OjasMishra32/volition/design/out/torque_speed_hip.png

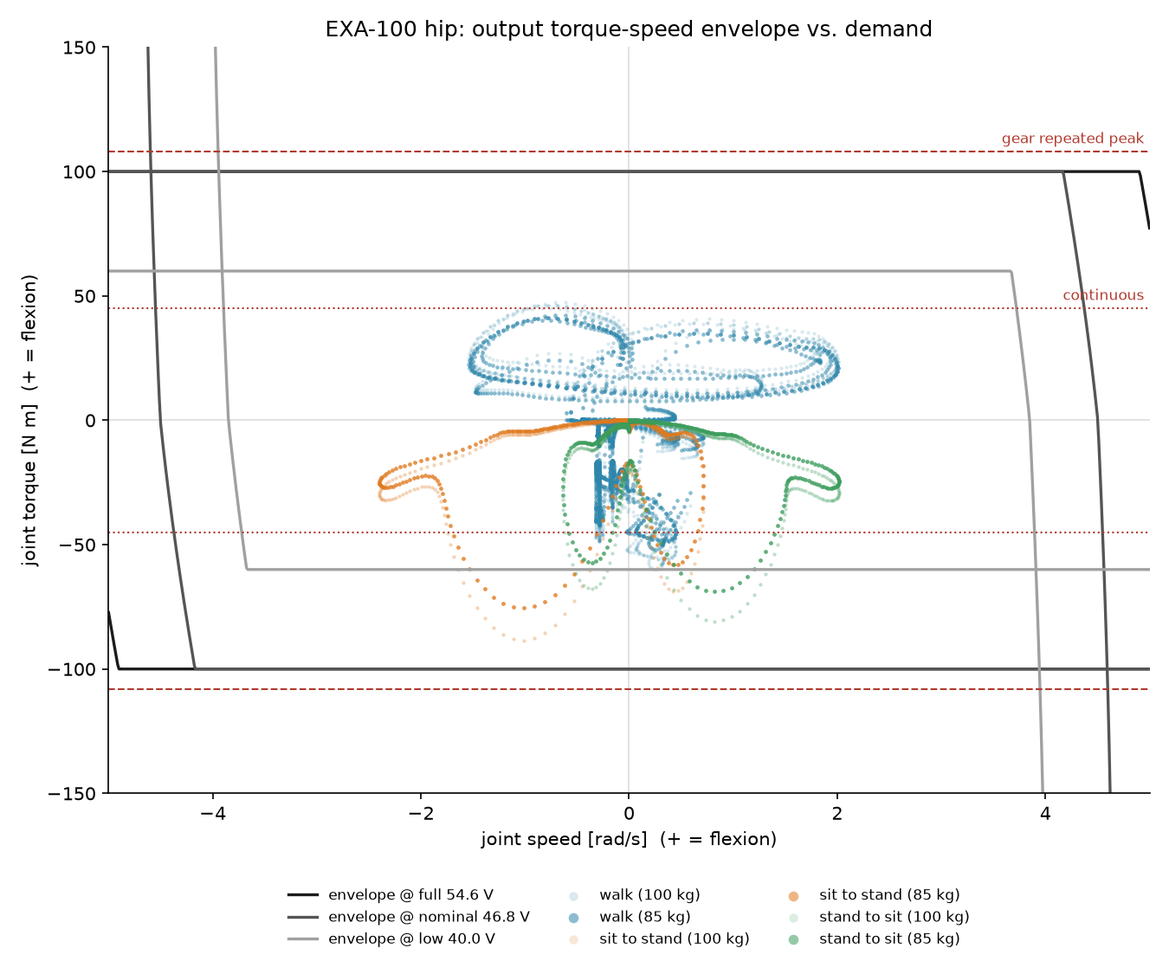
design/out/torque_speed_hip.png
