OjasMishra32/volition/design/out/torque_speed_knee.png

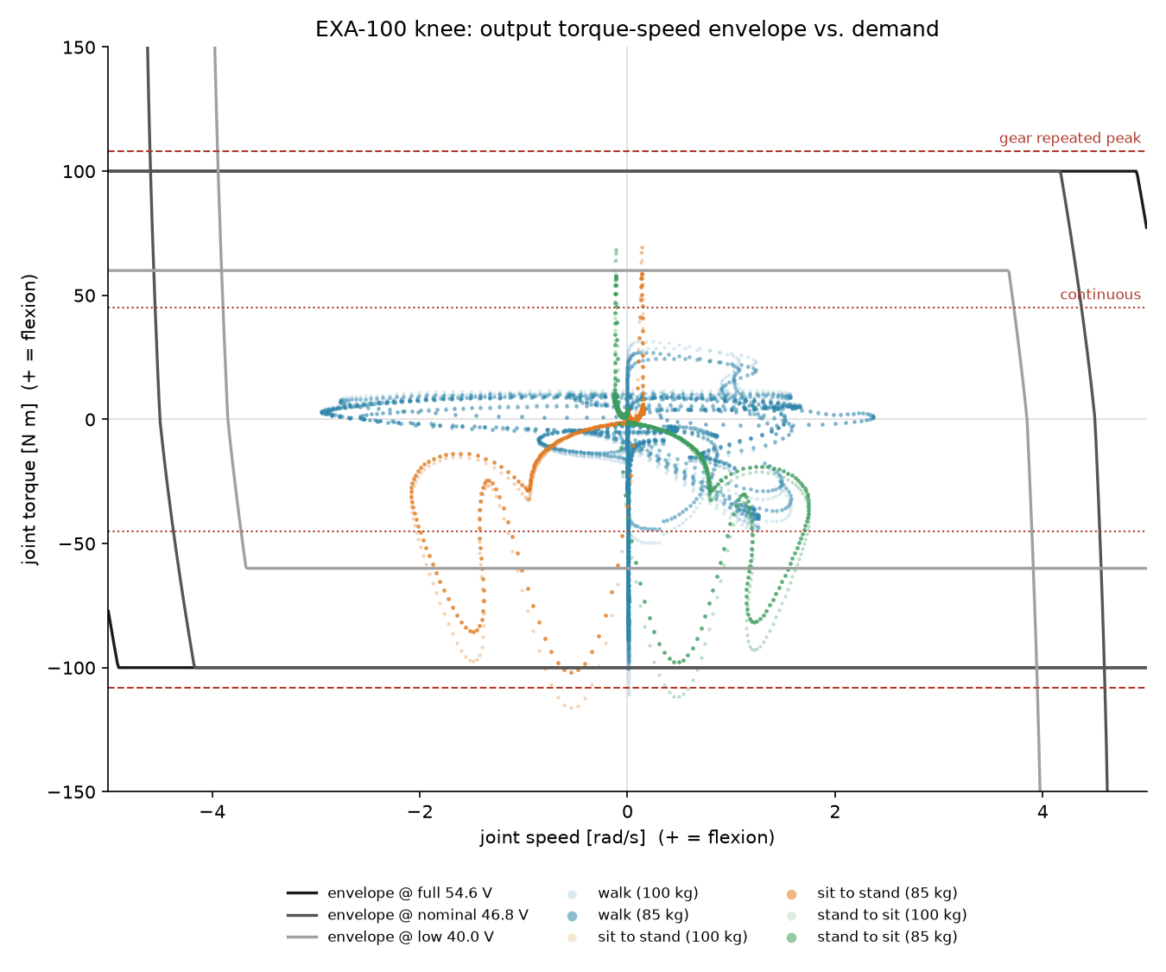
design/out/torque_speed_knee.png
