OjasMishra32/volition/sim/out/kinematics_check.png

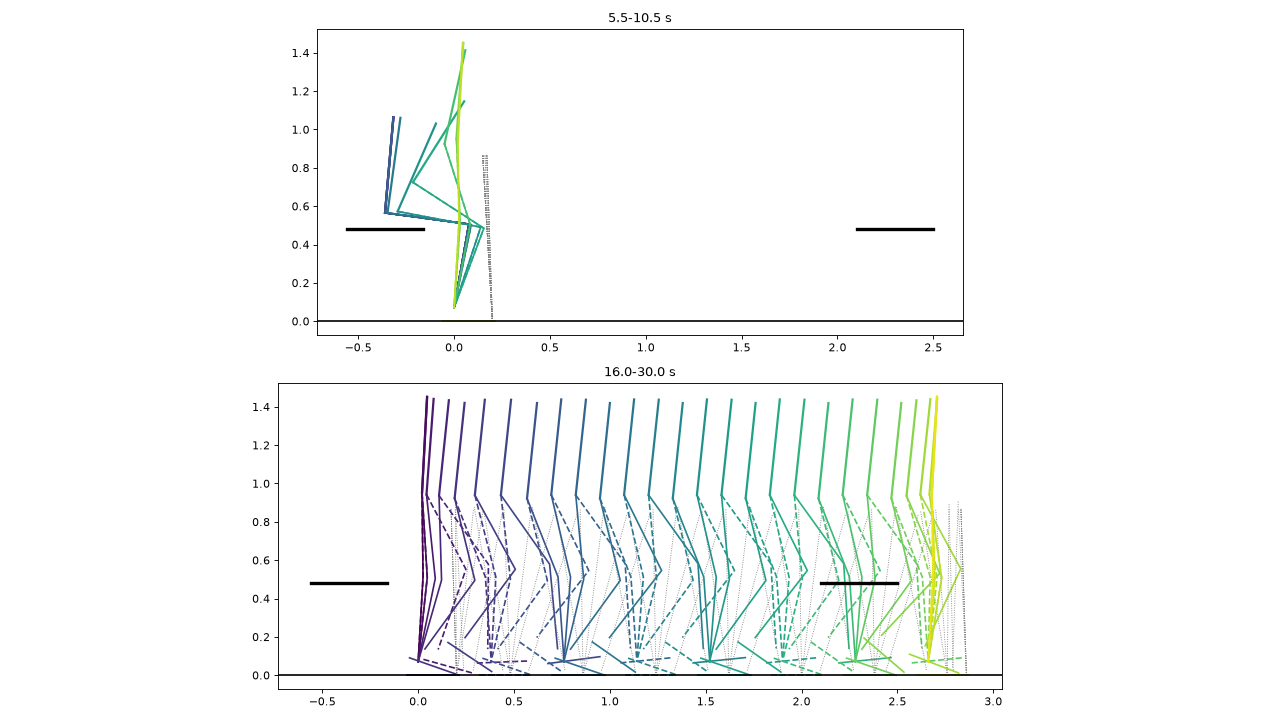
sim/out/kinematics_check.png
