OjasMishra32/volition/site/actuator_exploded.png

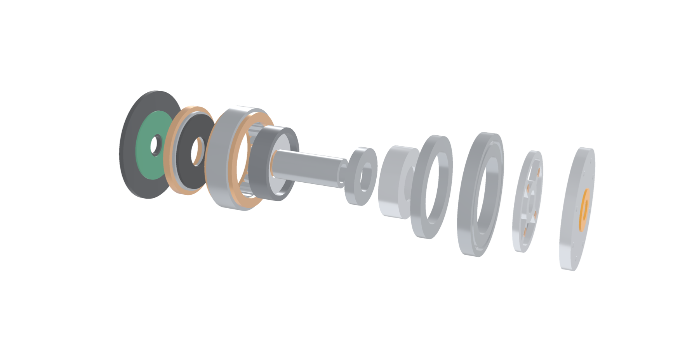
site/actuator_exploded.png
