OjasMishra32/volition/site/exo_front.png

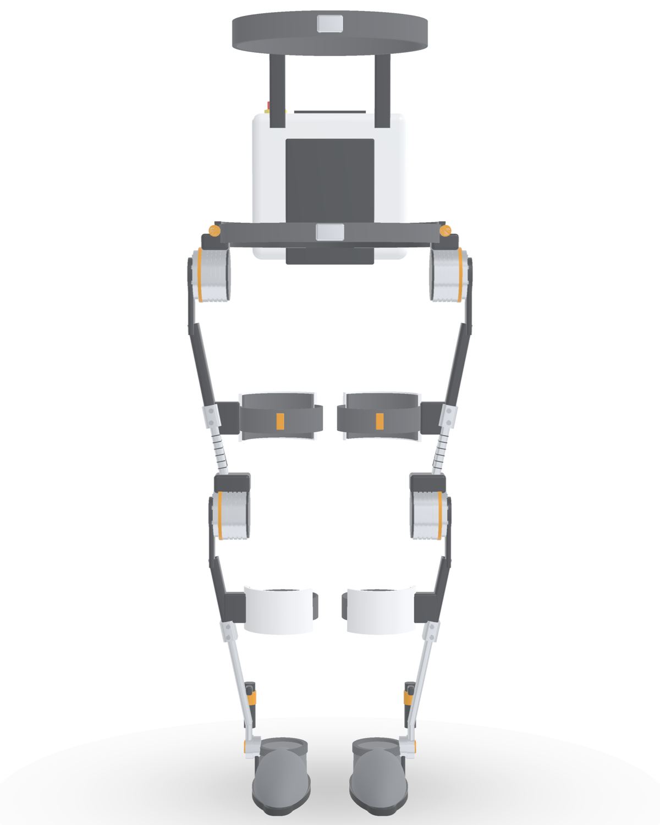
site/exo_front.png
