OjasMishra32/volition/site/exo_side.png

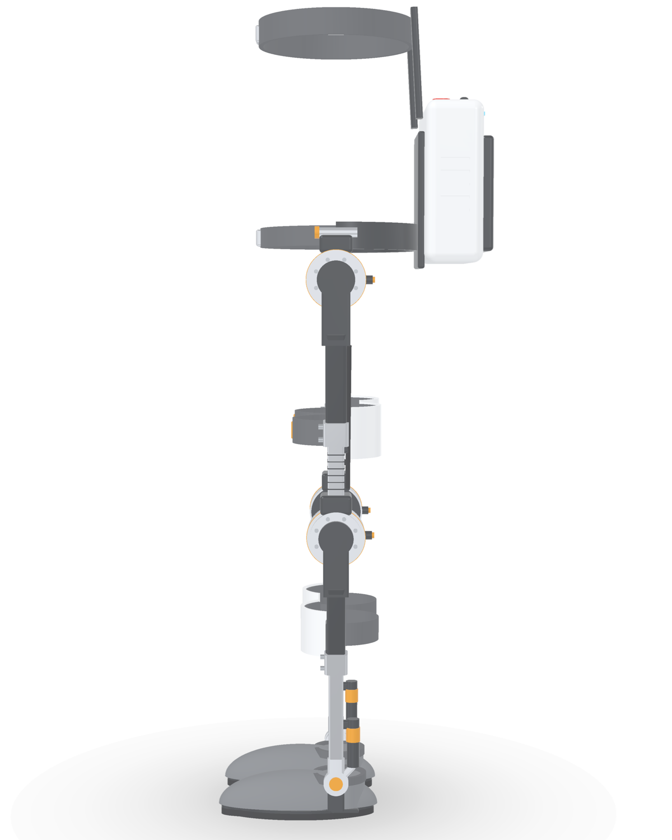
site/exo_side.png
