OjasMishra32/volition/cad/out/EXA-100_actuator.step

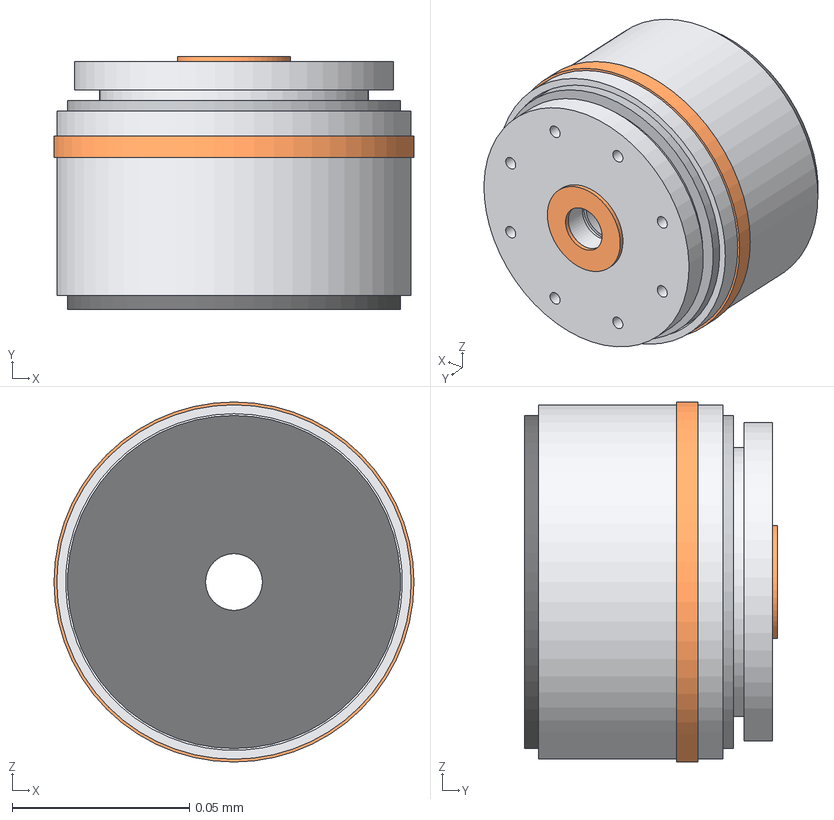
[picture p8: CAD file, 2026-10-31]
cad/out/EXA-100_actuator.step
0.102 x 0.0715 x 0.102 mm
housing
housing_accent
rear_cover
motor_encoder_pcb
brake_coil
brake_armature
brake_friction_disc
stator
end_turns_rear
end_turns_front
rotor_magnets
rotor_hub
hollow_shaft
wave_generator
flexspline
circular_spline
xrb_outer
xrb_inner
xrb_roller_0
xrb_roller_1
xrb_roller_2
xrb_roller_3
xrb_roller_4
xrb_roller_5
xrb_roller_6
xrb_roller_7
xrb_roller_8
xrb_roller_9
xrb_roller_10
xrb_roller_11
xrb_roller_12
xrb_roller_13
xrb_roller_14
xrb_roller_15
xrb_roller_16
xrb_roller_17
xrb_roller_18
xrb_roller_19
xrb_roller_20
xrb_roller_21
xrb_roller_22
xrb_roller_23
xrb_roller_24
xrb_roller_25
xrb_roller_26
xrb_roller_27
strain_gauge_0
strain_gauge_1
strain_gauge_2
strain_gauge_3
torque_sensor_flexure
output_encoder_ring
output_flange
output_cap
