OjasMishra32/volition/cad/out/parts/shank_R.step

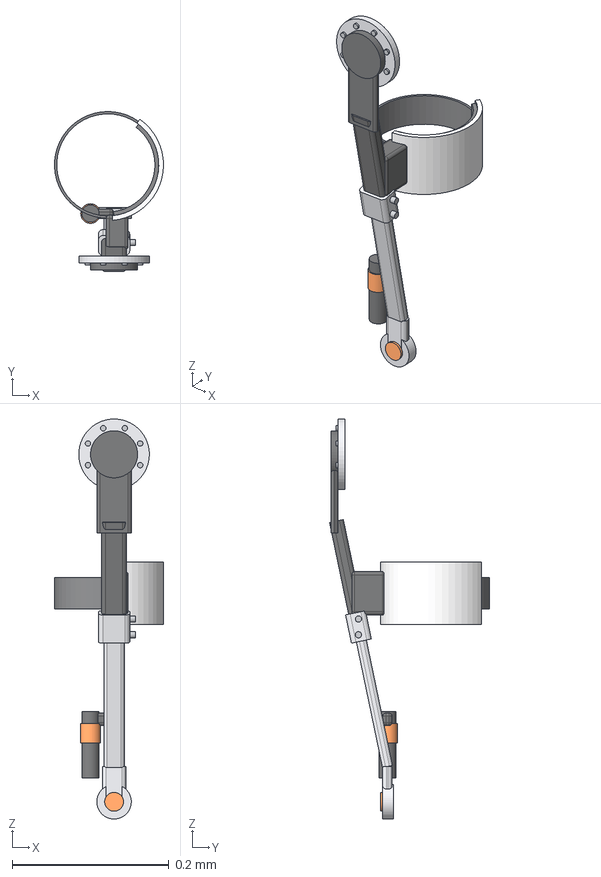
[picture p9: CAD file, 2026-10-31]
cad/out/parts/shank_R.step
0.139 x 0.204 x 0.51 mm
shank_R_alu
shank_R_steel
shank_R_indicator
shank_R_carbon
shank_R_accent
shank_R_shell
shank_R_pad
