OjasMishra32/volition/cad/out/parts/pelvis.step

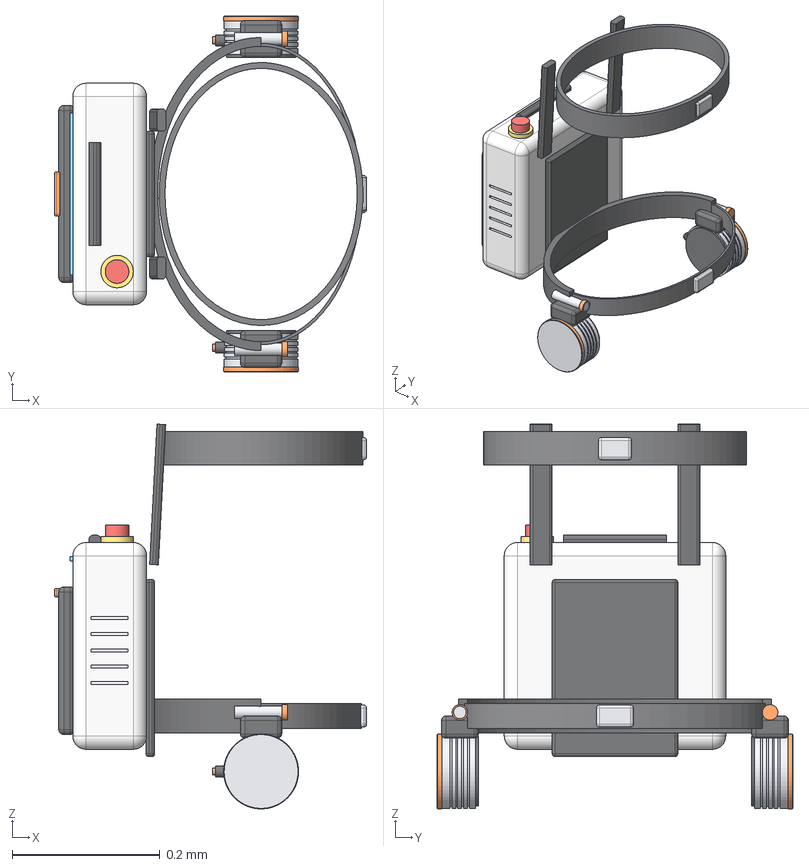
[picture p10: CAD file, 2026-10-31]
cad/out/parts/pelvis.step
0.423 x 0.482 x 0.521 mm
pelvis_alu
pelvis_carbon
pelvis_accent
pelvis_pad
pelvis_shell
pelvis_led
pelvis_yellow
pelvis_estop
