OjasMishra32/volition/cad/out/Volition_standing.step

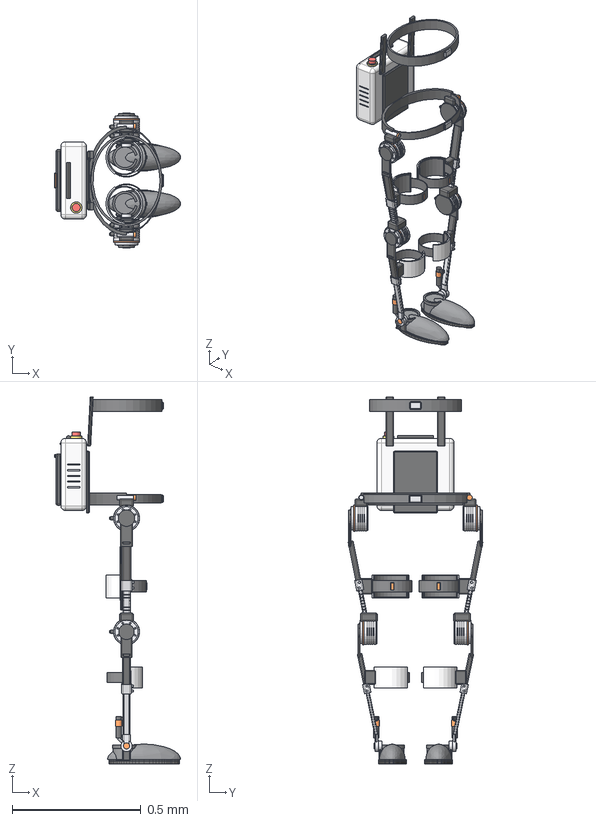
[picture p11: CAD file, 2026-10-31]
cad/out/Volition_standing.step
0.49 x 0.524 x 1.42 mm
pelvis_alu
pelvis_carbon
pelvis_accent
pelvis_pad
pelvis_shell
pelvis_led
pelvis_yellow
pelvis_estop
thigh_L_alu
thigh_L_steel
thigh_L_indicator
thigh_L_carbon
thigh_L_rubber
thigh_L_accent
thigh_L_shell
thigh_L_pad
shank_L_alu
shank_L_steel
shank_L_indicator
shank_L_carbon
shank_L_accent
shank_L_shell
shank_L_pad
foot_L_rubber
foot_L_carbon
foot_L_fabric
foot_L_pad
foot_L_alu
thigh_R_alu
thigh_R_steel
thigh_R_indicator
thigh_R_carbon
thigh_R_rubber
thigh_R_accent
thigh_R_shell
thigh_R_pad
shank_R_alu
shank_R_steel
shank_R_indicator
shank_R_carbon
shank_R_accent
shank_R_shell
shank_R_pad
foot_R_rubber
foot_R_carbon
foot_R_fabric
foot_R_pad
foot_R_alu
