OjasMishra32/volition/cad/out/parts/foot_R.step

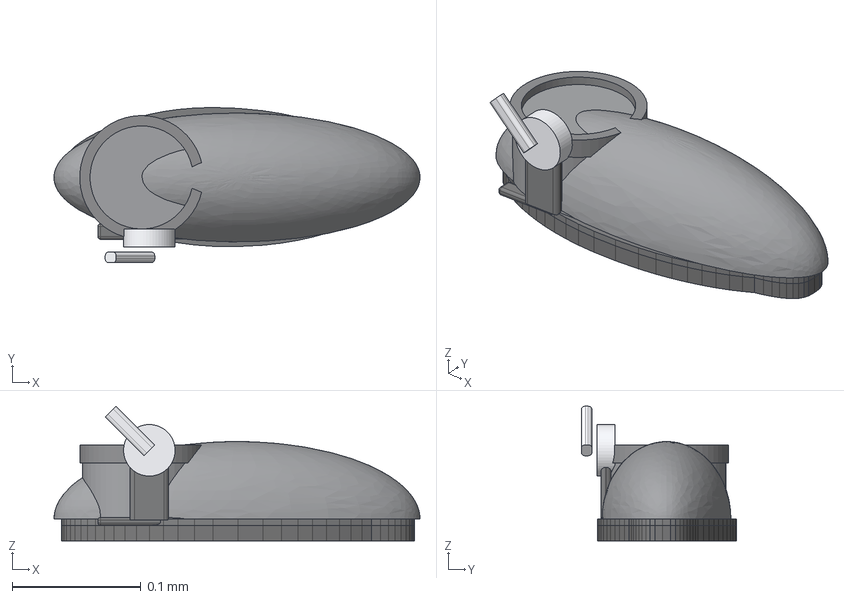
[picture p12: CAD file, 2026-10-31]
cad/out/parts/foot_R.step
0.284 x 0.12 x 0.104 mm
foot_R_rubber
foot_R_carbon
foot_R_fabric
foot_R_pad
foot_R_alu
