OjasMishra32/volition/cad/out/parts/thigh_L.step

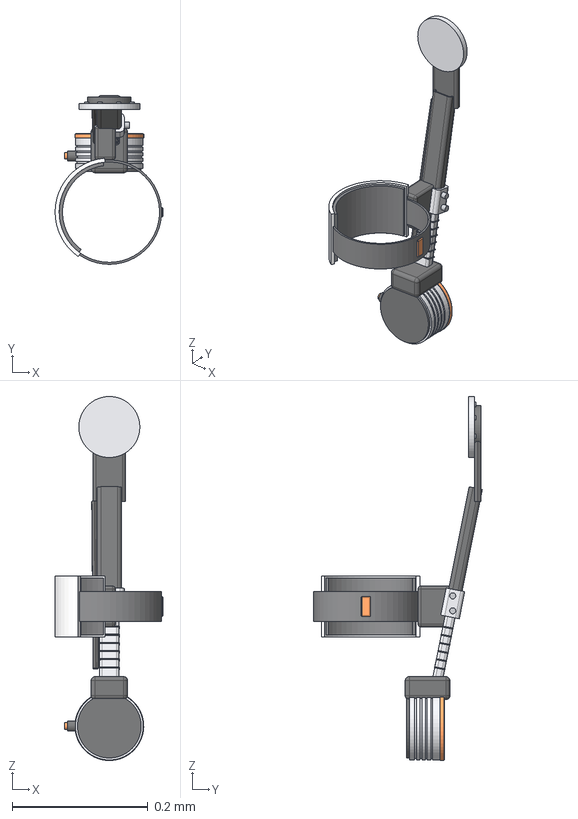
[picture p13: CAD file, 2026-10-31]
cad/out/parts/thigh_L.step
0.159 x 0.249 x 0.537 mm
thigh_L_alu
thigh_L_steel
thigh_L_indicator
thigh_L_carbon
thigh_L_rubber
thigh_L_accent
thigh_L_shell
thigh_L_pad
