OjasMishra32/volition/(list of files, cad)

Other CAD files:
cad/out/parts/shank_L.step
cad/out/parts/foot_L.step
cad/out/parts/thigh_R.step
